yohanselregalado/Yohansel_Regalado_Electiva_2026_C2/Tarea 2/Case PLC.FCStd

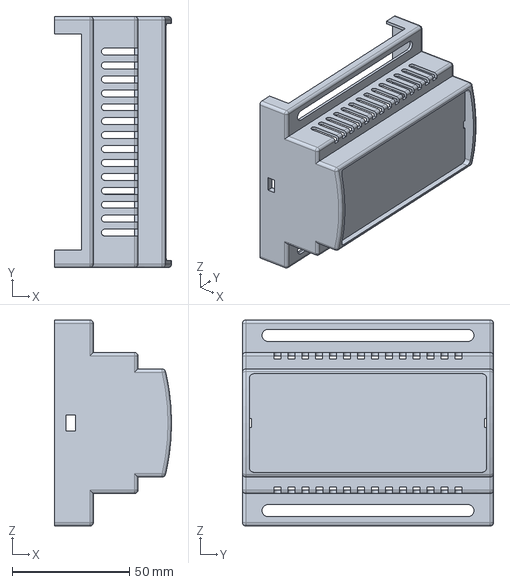
[picture p1: CAD file, 2026-06-11]
Tarea 2/Case PLC.FCStd
49.8 x 107.0 x 87.7 mm
