yohanselregalado/Yohansel_Regalado_Electiva_2026_C2/Tarea 2/Case PLC parte inferior.FCStd

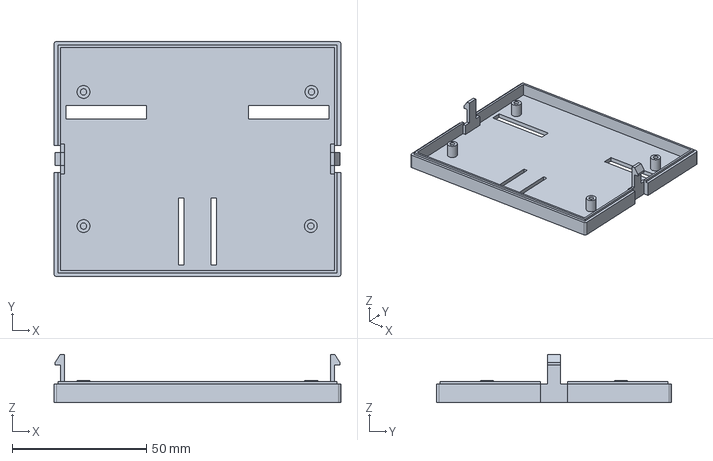
[picture p2: CAD file, 2026-06-11]
Tarea 2/Case PLC parte inferior.FCStd
107.0 x 87.7 x 18.0 mm
