yohanselregalado/Yohansel_Regalado_Electiva_2026_C2/tarea 5/PLC4UNI MEZZANINE.kicad_pcb

## KiCad design tarea 5/PLC4UNI MEZZANINE.kicad_pcb (2026-08-13)

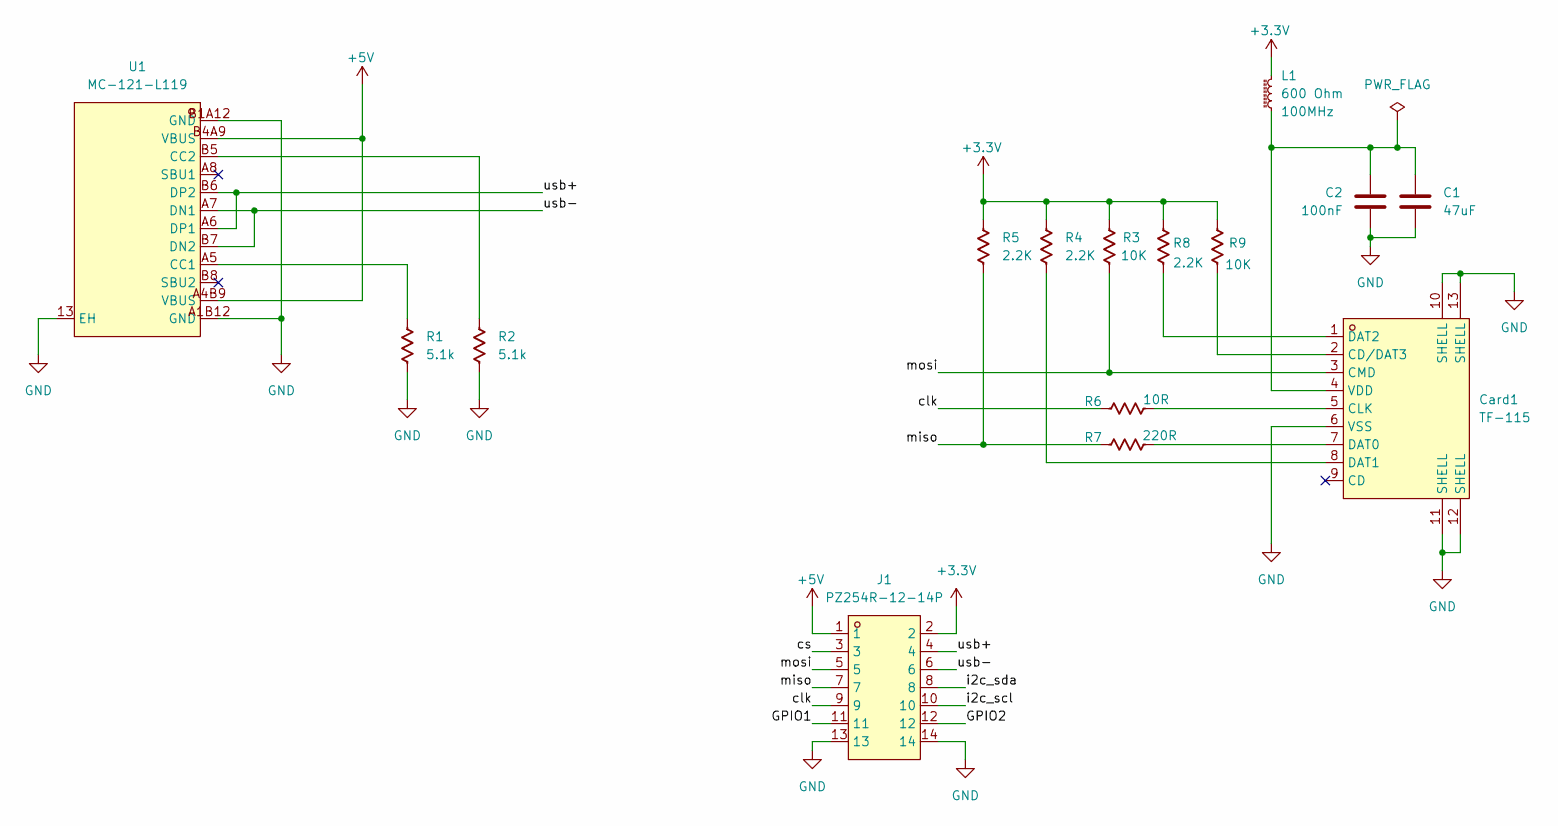
[picture p3: schematic PLC4UNI MEZZANINE.kicad_sch]

Parts:
C1: 47uF; C_0603_1608Metric
C2: 100nF; C_0603_1608Metric
Card1: TF-115; TF-SMD_TF-115; LCSC Part C266620
J1: PZ254R-12-14P; HDR-TH_14P-P2.54-H-M-R2-C7-S2.54; LCSC Part C492435
L1: 600 Ohm; C_0805_2012Metric
R1, R2: 5.1k; R_0603_1608Metric
R3, R9: 10K; R_0603_1608Metric
R4, R5, R8: 2.2K; R_0603_1608Metric
R6: 10R; R_0603_1608Metric
R7: 220R; R_0603_1608Metric
U1: MC-121-L119; USB-C-SMD_HANBO_MC-121-L119; LCSC Part C6332278

Connections:
+3.3V: J1.2, L1.2, R3.1, R4.1, R5.1, R8.1, R9.1
+5V: J1.1, U1.A4B9 (VBUS), U1.B4A9 (VBUS)
/GPIO1: J1.11
/GPIO2: J1.12
/clk: J1.9, R6.1
/cs: J1.3
/i2c_scl: J1.10
/i2c_sda: J1.8
/miso: J1.7, R5.2, R7.1
/mosi: Card1.3 (CMD), J1.5, R3.2
/usb+: J1.4, U1.A6 (DP1), U1.B6 (DP2)
/usb-: J1.6, U1.A7 (DN1), U1.B7 (DN2)
GND: C1.2, C2.2, Card1.6 (VSS), Card1.10 (SHELL), Card1.11 (SHELL), Card1.12 (SHELL), Card1.13 (SHELL), J1.13, J1.14, R1.2, R2.2, U1.13 (EH), U1.A1B12 (GND), U1.B1A12 (GND)
unnamed: Card1.2 (CD/DAT3), R9.2
unnamed: Card1.5 (CLK), R6.2
unnamed: Card1.7 (DAT0), R7.2
unnamed: Card1.8 (DAT1), R4.2
unnamed: Card1.1 (DAT2), R8.2
unnamed: C1.1, C2.1, Card1.4 (VDD), L1.1
unnamed: R1.1, U1.A5 (CC1)
unnamed: R2.1, U1.B5 (CC2)

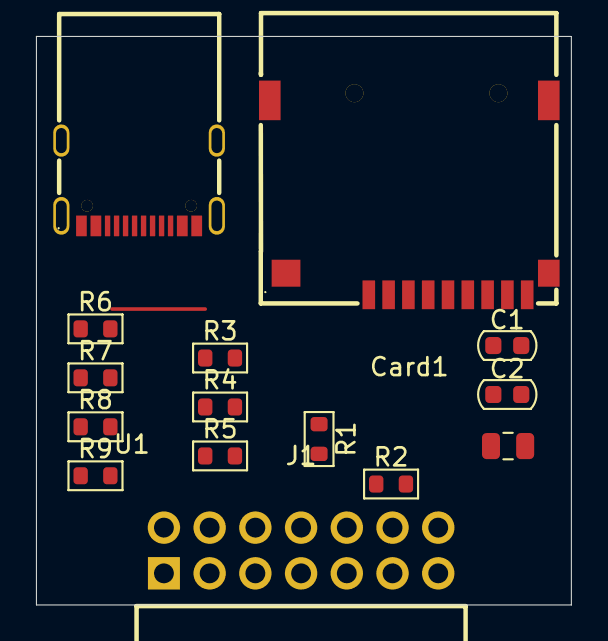
[picture p4: board PLC4UNI MEZZANINE.kicad_pcb from above]

Board: 2 copper layers, 29.7 x 31.6 mm, 15 parts (0 on the bottom side), 16 nets.
