yohanselregalado/Yohansel_Regalado_Electiva_2026_C2/Tarea 3 y 4/tarea 3 y 4/PLC4UNI.kicad_pcb

## KiCad design Tarea 3 y 4/tarea 3 y 4/PLC4UNI.kicad_pcb (2026-07-17)

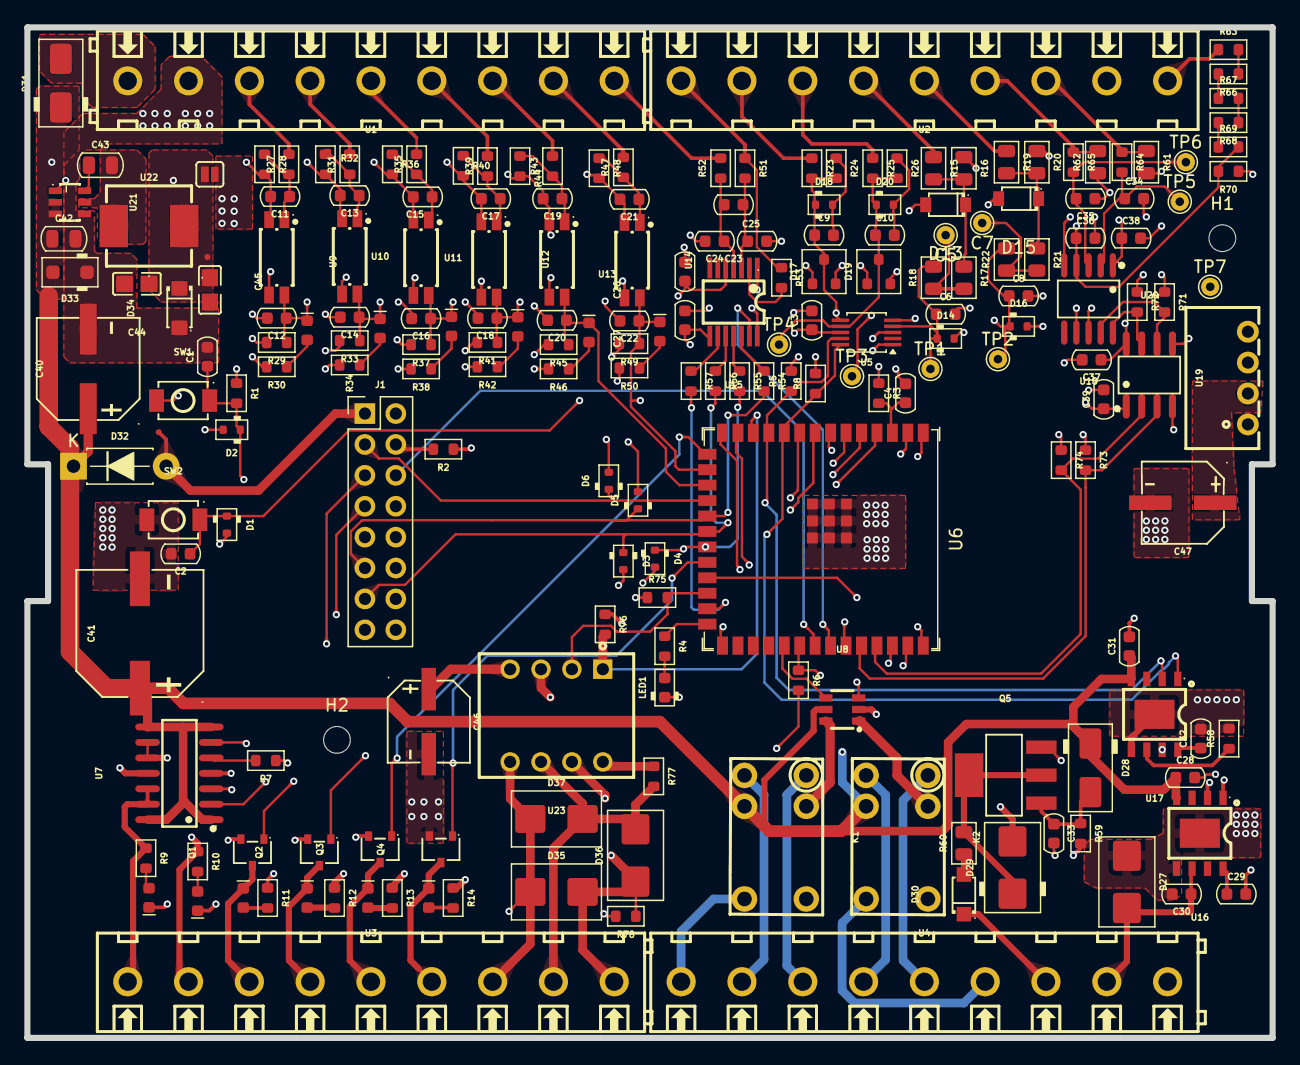
[picture p5: board PLC4UNI.kicad_pcb from above]

Board: 4 copper layers, 102.4 x 83.1 mm, 209 parts (0 on the bottom side), 134 nets.

Parts:
C1, C2, C6, C8: 47pF; C_0603_1608Metric
C3, C9, C10, C23, C24, C25, C26, C27, C30, C37, C38, C39: 100nF; C_0603_1608Metric
C4, C28, C29, C33: 1uF; C_0603_1608Metric
C5, C7: 100nF; TestPoint_THTPad_D1.5mm_Drill0.7mm
C11, C12, C13, C14, C15, C16, C17, C18, C19, C20, C21, C22, C31, C32: C_0603; C_0603_1608Metric
C34, C35: 33nF; C_0603_1608Metric
C36: 68nF; C_0603_1608Metric
C40: 100uF/50V; CAP-SMD_BD8.0-L8.3-W8.3-FD
C41: 220uF/50V; CAP-SMD_BD10.0-L10.3-W10.3-LS11.3-FD
C42: 10uF/50V; C_0805_2012Metric
C43: 100nF; C_0805_2012Metric
C44, C45: 22uF/16V; C0805
C46, C47: 47uF/16V; CAP-SMD_BD6.3-L6.6-W6.6-FD
D1, D2, D3, D4, D5, D6: ESD5Z3.3T; D_SOD-523
D7, D8, D9, D10, D11, D12, D21, D22, D23, D24, D25, D26: Red; LED_0603_1608Metric_Red
D13, D15: 1N5819HW-7-F; SOD-123_L2.7-W1.6-LS3.7-RD
D14, D16, D18, D20: PESD5Z3.3; D_SOD-523
D17, D19: BAT54S; SOT-23
D27, D35, D36, D37: SMBJ12CA; D_SMB_TVS
D28: SMAJ12A; D_SMA
D29: SMBJ28A; D_SMB
D30: DSK120_C22466355; SOD-123FL_L2.7-W1.8-LS3.8-RD
D31: MBRA340T; D_SMA
D32: 1N5819; D_DO-41_SOD81_P7.62mm_Horizontal
D33: SMF24CA; D_SOD-123F
D34: SMF3.3; SOD-123FL_L3.0-W1.9-LS3.7-FD
H1, H2: MountingHole; MountingHole_2.2mm_M2_DIN965
J1: Conn_02x08_Odd_Even; PinHeader_2x08_P2.54mm_Vertical
JP1: Jumper_2_NO
K1, K2: G5V-1-DC3; RELAY-TH_G5V-1
LED1: LED_0603_Red; LED_0603_1608Metric
Q1, Q2, Q3, Q4: ZXMS6004FFQTA; SOT-23F_L2.9-W1.8-P0.95-LS2.4-BR
Q5: NCE60P04R; SOT-223-3_L6.5-W3.4-P2.30-LS7.0-BR
R1: 100k; R_0603_1608Metric
R2, R6, R7, R51, R52: 0R; R_0603_1608Metric
R3, R65, R77, R78: 1k; R_0603_1608Metric
R4: 2.2k; R_0603_1608Metric
R5, R8: 4.7k; R_0603_1608Metric
R9, R10, R11, R12, R13, R14, R58, R71, R72, R73, R74: R_0603; R_0603_1608Metric
R15, R19: 49.9R; R_0805_2012Metric
R16, R20: 120R; R_0805_2012Metric
R17, R18, R21, R22: R_0805; R_0805_2012Metric
R23, R25: 2.2K; R_0603_1608Metric
R24, R26: 1.05K; R_0603_1608Metric
R27, R31, R35, R39, R43, R47: 3.3K; R_0603_1608Metric
R28, R32, R36, R40, R44, R48: 3.6K; R_0603_1608Metric
R29, R33, R37, R41, R45, R49: 22K; R_0603_1608Metric
R30, R34, R38, R42, R46, R50: 220R; R_0603_1608Metric
R53: 20K; R_0603_1608Metric
R54, R55, R56, R57: 150R; R_0603_1608Metric
R59: 470K; R_0603_1608Metric
R60: 15R; R_0805_2012Metric
R61, R62: R51; R_0805_2012Metric
R63, R66, R67, R68, R69: 390k; R_0603_1608Metric
R64: 1K; R_0603_1608Metric
R70: 510; R_0603_1608Metric
R75, R76: 10k; R_0603_1608Metric
SW1, SW2: TS-1088-AR02016; SW-SMD_L3.9-W3.0-P4.45
TP1, TP2, TP3, TP4, TP5, TP6, TP7: TestPoint; TestPoint_THTPad_D1.5mm_Drill0.7mm
TP8, TP9, TP10: 0.5mm; TestPoint-0.5mm
U1, U2, U3, U4: ScrewTerminal1-1x9-P5.0mm; CONN-TH_9P-P5.00_DB127V-5.0-9P-GN-S
U5: ADS1115IDGS; TSSOP-10_3x3mm_P0.5mm
U6: ESP32-S3-WROOM-1; ESP32-S3-WROOM-1U
U7: BTS723GWXUMA1; SOIC-14_L8.7-W3.9-P1.27-LS6.0-BL
U8: LK1802; SOT-23-6_L2.9-W1.6-P0.95-LS2.8-BR
U9, U10, U11, U12, U13, U14: AT3H4B-CUH-S; SSOP-4_L2.7-W4.6-P1.27-LS7.0-TL
U15: MAX31856MUD+; TSSOP-14_L5.0-W4.4-P0.65-LS6.4-BL
U16: GP8211S-TC50-EW; ESOP-8_L4.9-W3.9-P1.27-LS6.0-BL-EP
U17: GP8302-TC50-EW; ESOP-8_L4.9-W3.9-P1.27-LS6.0-BL-EP
U18: BL0942; SSOP-10_L4.9-W3.9-P1.00-LS6.0-BL
U19: B0303S-1WR3_C7465185; PWRM-TH_BXXXXS-1WR3
U20: ISO7021DR; SOIC-8_L4.9-W3.9-P1.27-LS6.0-BL
U21: AP63203WU-7; TSOT-26_L2.9-W1.6-P0.95-LS2.8-BL
U22: APH0630T4R7M; IND-SMD_L7.0-W6.6_APH0630
U23: TD301M485_C5451847; COMM-TH_TD301M485

Connections:
3.3V: C3.1, C26.1, C27.1, C39.1, C46.1, C47.1, D17.2 (K), D19.2 (K), J1.2, JP1.2 (B), R1.1, R2.1, R3.1, R5.2, R8.2, R11.1, R12.1, R13.1, R14.1, R29.2, R30.2, R33.2, R34.2, R37.2, R38.2, R41.2, R42.2, R45.2, R46.2, R49.2, R50.2, R73.1, R74.1, R75.1, R76.1, U5.8 (VDD), U6.2 (3V3), U7.11 (SPU), U15.5 (AVDD), U15.8 (DVDD), U19.2 (+Vin), U20.1 (VCC1), U23.4 (VCC)
3.3V_P: C37.1, C38.1, R71.1, R72.1, TP7.1 (1_1), U18.1 (VDD), U18.8 (SCLK_BPS), U19.4 (+Vout), U20.8 (VCC2)
+5V: D32.2 (A), J1.1, TP8.1 (1_1)
+24V: D31.2 (A), U1.9
/plc4uni_top/CON-IN_CT_N: R62.2, R65.1, U2.4
/plc4uni_top/CON-IN_CT_P: R61.1, R64.1, U2.3
/plc4uni_top/CON_IN_0-10V_1: R23.1, U2.8
/plc4uni_top/CON_IN_0-10V_2: R25.1, U2.7
/plc4uni_top/CON_IN_4-20MA_1: R15.1, U2.6
/plc4uni_top/CON_IN_4-20MA_2: R19.1, U2.5
/plc4uni_top/CON_IN_NPN1: R27.2, U1.7
/plc4uni_top/CON_IN_NPN2: R31.2, U1.6
/plc4uni_top/CON_IN_NPN3: R35.2, U1.5
/plc4uni_top/CON_IN_NPN4: R39.2, U1.4
/plc4uni_top/CON_IN_PNP1: R43.2, U1.3
/plc4uni_top/CON_IN_PNP2: R47.2, U1.2
/plc4uni_top/CON_IN_TC+: R52.2, U1.1
/plc4uni_top/CON_IN_TC-: R51.1, R53.1, U2.9
/plc4uni_top/CON_IN_VAC-P: R63.1, U2.1
/plc4uni_top/CON_OUT_0-10V_1: C30.1, D27.2 (A), U4.8, U16.6 (VOUT)
/plc4uni_top/CON_OUT_4-20MA_1: D30.1, U4.7
/plc4uni_top/CON_OUT_NPN1: D9.1 (K), Q1.3 (D), U3.3
/plc4uni_top/CON_OUT_NPN2: D10.1 (K), Q2.3 (D), U3.4
/plc4uni_top/CON_OUT_NPN3: D11.1 (K), Q3.3 (D), U3.5
/plc4uni_top/CON_OUT_NPN4: D12.1 (K), Q4.3 (D), U3.6
/plc4uni_top/CON_OUT_PNP1: R9.1, U3.1, U7.12 (OUT1), U7.13 (OUT1)
/plc4uni_top/CON_OUT_PNP2: R10.1, U3.2, U7.9 (OUT2), U7.10 (OUT2)
/plc4uni_top/CON_OUT_RLY1-COM: K1.5, U4.1
/plc4uni_top/CON_OUT_RLY1-NC: K1.1, U4.2
/plc4uni_top/CON_OUT_RLY1-NO: K1.10, U4.3
/plc4uni_top/CON_OUT_RLY2-COM: K2.5, U4.6
/plc4uni_top/CON_OUT_RLY2-NC: K2.1, U4.4
/plc4uni_top/CON_OUT_RLY2-NO: K2.10, U4.5
/plc4uni_top/CON_RS485_A: D35.2 (A), D36.1 (K), R78.1, U3.9, U23.7 (B)
/plc4uni_top/CON_RS485_B: D36.2 (A), D37.2 (A), R77.2, U3.8, U23.6 (A)
/plc4uni_top/CON_RS485_G: D35.1 (K), D37.1 (K), R78.2, U3.7, U23.5 (RGND)
/plc4uni_top/EMRX: R73.2, U6.36 (U0RXD/GPIO44/CLK_OUT2), U20.3 (INB)
/plc4uni_top/EM_TX: R74.2, U6.37 (U0TXD/GPIO43/CLK_OUT1), U20.2 (OUTA)
/plc4uni_top/EN: C4.1, R3.2, U6.3 (EN)
/plc4uni_top/I2C_SCK: J1.10, R8.1, U5.10 (SCL), U6.10 (GPIO17/U1TXD/ADC2_CH6), U16.1 (SCLK), U17.1 (SLCK)
/plc4uni_top/I2C_SDA: J1.8, R5.1, U5.9 (SDA), U6.11 (GPIO18/U1RXD/ADC2_CH7/CLK_OUT3), U16.2 (SDA), U17.2 (SDA)
/plc4uni_top/IN-0-10V1/COM: C10.2, D20.2 (A), R26.1
/plc4uni_top/IN-0-10V1/OUT3V3: C10.1, D19.3 (C), D20.1 (K), R25.2, R26.2, TP4.1 (1_1), U5.7 (AIN3)
/plc4uni_top/IN-0-10V/COM: C9.2, D18.2 (A), R24.1
/plc4uni_top/IN-0-10V/OUT3V3: C9.1, D17.3 (C), D18.1 (K), R23.2, R24.2, TP3.1 (1_1), U5.6 (AIN2)
/plc4uni_top/IN-4-20MA1/OUT: C8.1, D16.1 (K), R22.2, TP2.1 (1_1), U5.5 (AIN1)
/plc4uni_top/IN-4-20MA/OUT: C6.1, D14.1 (K), R18.2, TP1.1 (1_1), U5.4 (AIN0)
/plc4uni_top/IN_NPN1: C12.1, D21.1 (K), R29.1, U6.4 (GPIO4/TOUCH4/ADC1_CH3), U9.4 (COL)
/plc4uni_top/IN_NPN2: C14.1, D22.1 (K), R33.1, U6.5 (GPIO5/TOUCH5/ADC1_CH4), U10.4 (COL)
/plc4uni_top/IN_NPN3: C16.1, D23.1 (K), R37.1, U6.6 (GPIO6/TOUCH6/ADC1_CH5), U11.4 (COL)
/plc4uni_top/IN_NPN4: C18.1, D24.1 (K), R41.1, U6.7 (GPIO7/TOUCH7/ADC1_CH6), U12.4 (COL)
/plc4uni_top/IN_PNP1: C20.1, D25.1 (K), R45.1, U6.17 (GPIO9/TOUCH9/ADC1_CH8/FSPIHD/SUBSPIHD), U13.4 (COL)
/plc4uni_top/IN_PNP2: C2.1, C22.1, D1.1 (K), D26.1 (K), R49.1, SW2.2, U6.16 (GPIO46), U14.4 (COL)
/plc4uni_top/LCD_CS: J1.7, U6.35 (MTMS/GPIO42)
/plc4uni_top/LCD_EN: J1.4, R2.2
/plc4uni_top/LED_INFO: R4.1, U6.26 (GPIO45)
/plc4uni_top/OUT-PNP/ST1: R6.2, U7.3 (ST1)
/plc4uni_top/OUT-PNP/ST2: R7.2, U7.5 (ST2)
/plc4uni_top/OUT_NPN1: Q1.1 (IN), U6.39 (GPIO1/TOUCH1/ADC1_CH0)
/plc4uni_top/OUT_NPN2: Q2.1 (IN), U6.38 (GPIO2/TOUCH2/ADC1_CH1)
/plc4uni_top/OUT_NPN3: Q3.1 (IN), U6.15 (GPIO3/TOUCH3/ADC1_CH2)
/plc4uni_top/OUT_NPN4: Q4.1 (IN), U6.22 (GPIO14/TOUCH14/ADC2_CH3/FSPIWP/FSPIDQS/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)
/plc4uni_top/OUT_PNP1: U6.8 (GPIO15/U0RTS/ADC2_CH4/XTAL_32K_P), U7.2 (IN1)
/plc4uni_top/OUT_PNP2: U6.9 (GPIO16/U0CTS/ADC2_CH5/XTAL_32K_N), U7.6 (IN2)
/plc4uni_top/OUT_RLY1: U6.23 (GPIO21), U8.3 (1B)
/plc4uni_top/OUT_RLY2: U6.31 (GPIO38/FSPIWP/SUBSPIWP), U8.4 (2B)
/plc4uni_top/RESET: C1.1, D2.1 (K), J1.5, R1.2, SW1.2, U6.27 (GPIO0/BOOT)
/plc4uni_top/RS485-RX: R76.2, U6.12 (GPIO8/TOUCH8/ADC1_CH7/SUBSPICS1), U23.1 (RXD)
/plc4uni_top/RS485-TX: R75.2, U6.24 (GPIO47/SPICLK_P/SUBSPICLK_P_DIFF), U23.2 (TXD)
/plc4uni_top/SD_CS: D6.1 (K), J1.3, U6.18 (GPIO10/TOUCH10/ADC1_CH9/FSPICS0/FSPIIO4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)
/plc4uni_top/SPI_CLK: D3.1 (K), J1.13, R56.2, U6.20 (GPIO12/TOUCH12/ADC2_CH1/FSPICLK/FSPIIO6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)
/plc4uni_top/SPI_MISO: D4.1 (K), J1.9, R55.2, U6.21 (GPIO13/TOUCH13/ADC2_CH2/FSPIQ/FSPIIO7/S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)
/plc4uni_top/SPI_MOSI: D5.1 (K), J1.11, R54.2, U6.19 (GPIO11/TOUCH11/ADC2_CH0/FSPID/FSPIIO5/S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)
/plc4uni_top/ST1_ST2: R6.1, R7.1, U6.32 (MTCK/GPIO39/CLK_OUT3/SUBSPICS1)
/plc4uni_top/TC_FAULT: U6.34 (MTDI/GPIO41/CLK_OUT1), U15.13 (~FAULT)
/plc4uni_top/TEMP_CS: R57.2, U6.25 (GPIO48/SPICLK_N/SUBSPICLK_N_DIFF)
/plc4uni_top/TP_INT: J1.6, U6.33 (MTDO/GPIO40/CLK_OUT2)
/plc4uni_top/USB+: J1.14, U6.14 (GPIO20/U1CTS/ADC2_CH9/CLK_OUT1/USB_D+)
/plc4uni_top/USB-: J1.12, U6.13 (GPIO19/U1RTS/ADC2_CH8/CLK_OUT2/USB_D-)
Earth: C34.2, C35.1, C36.2, C37.2, C38.2, R61.2, R62.1, R70.1, U2.2, U18.5 (GND), U18.7 (SEL), U19.3 (-Vout), U20.5 (GND2)
GND: C1.2, C2.2, C3.2, C4.2, C6.2, C8.2, C12.2, C14.2, C16.2, C18.2, C19.2, C20.2, C21.2, C22.2, C24.2, C25.2, C26.2, C27.2, C28.2, C29.2, C30.2, C31.2, C32.2, C33.2, C39.2, C40.2, C41.2, C42.2, C44.2, C45.2, C46.2, C47.2, D1.2 (A), D2.2 (A), D3.2 (A), D4.2 (A), D5.2 (A), D6.2 (A), D7.1 (K), D8.1 (K), D13.2, D14.2 (A), D15.2, D16.2 (A), D17.1 (A), D19.1 (A), D27.1 (K), D29.2 (A), D33.1 (K), D34.1, J1.15, J1.16, LED1.1 (K), Q1.2 (S), Q2.2 (S), Q3.2 (S), Q4.2 (S), R16.1, R20.1, R44.2, R48.2, R58.2, R59.2, SW1.1, SW2.1, U1.8, U4.9, U5.1 (ADDR), U5.3 (GND), U6.1 (GND), U6.40 (GND), U6.41 (GND), U7.4 (GND), U8.2 (E), U9.3 (EM), U10.3 (EM), U11.3 (EM), U12.3 (EM), U13.2 (CAT/AN), U13.3 (EM), U14.2 (CAT/AN), U14.3 (EM), U15.1 (AGND), U15.14 (DGND), U16.5 (GND), U16.9 (EP), U17.5 (GND), U17.9 (EP), U19.1 (-Vin), U20.4 (GND1), U21.4 (GND), U23.3 (GND)
unnamed: C5.1, R17.2, R18.1
unnamed: C7.1, R21.2, R22.1
unnamed: D7.2 (A), R9.2
unnamed: D8.2 (A), R10.2
unnamed: D9.2 (A), R11.2
unnamed: D10.2 (A), R12.2
unnamed: D11.2 (A), R13.2
unnamed: D12.2 (A), R14.2
unnamed: D13.1, R15.2, R16.2, R17.1
unnamed: D15.1, R19.2, R20.2, R21.1
unnamed: D21.2 (A), R30.1
unnamed: D22.2 (A), R34.1
unnamed: D23.2 (A), R38.1
unnamed: D24.2 (A), R42.1
unnamed: D25.2 (A), R46.1
unnamed: D26.2 (A), R50.1
unnamed: C33.1, D28.2 (A), Q5.1 (G), R59.1
unnamed: D29.1 (K), Q5.2 (D), Q5.4 (D), R60.2
unnamed: D30.2, R60.1
unnamed: C44.1, C45.1, D34.2, JP1.1 (A), TP10.1 (1_1), U21.1 (FB), U22.2
unnamed: LED1.2 (A), R4.2
unnamed: Q5.3 (S), U17.7 (IOUT)
unnamed: R63.2, R66.1
unnamed: R66.2, R67.1
unnamed: R67.2, R68.1
unnamed: R68.2, R69.1
unnamed: K2.9, U8.1 (1C)
unnamed: K1.9, U8.6 (2C)
unnamed: C11.1, R27.1, R28.1, U9.1 (AN/CAT)
unnamed: C13.1, R31.1, R32.1, U10.1 (AN/CAT)
unnamed: C15.1, R35.1, R36.1, U11.1 (AN/CAT)
unnamed: C17.1, R39.1, R40.1, U12.1 (AN/CAT)
unnamed: C19.1, R43.1, R44.1, U13.1 (AN/CAT)
unnamed: C21.1, R47.1, R48.1, U14.1 (AN/CAT)
unnamed: R53.2, U15.2 (BIAS)
unnamed: R56.1, U15.10 (SCK)
unnamed: R54.1, U15.12 (SDI)
unnamed: R55.1, U15.11 (SDO)
unnamed: C23.2, C24.1, R52.1, U15.4 (T+)
unnamed: C23.1, C25.1, R51.2, U15.3 (T-)
unnamed: R57.1, U15.9 (~CS)
unnamed: C29.1, U16.8 (V5V)
unnamed: R58.1, U17.6 (SET)
unnamed: C32.1, U17.8 (V5V)
unnamed: C35.2, R65.2, TP6.1 (1_1), U18.3 (IN)
unnamed: C34.1, R64.2, TP5.1 (1_1), U18.2 (IP)
unnamed: R71.2, U18.9 (RX/SDI), U20.6 (OUTB)
unnamed: R72.2, U18.10 (TX/SDO), U20.7 (INA)
unnamed: C36.1, R69.2, R70.2, U18.4 (VP)
unnamed: C43.1, U21.6 (BST)
unnamed: C43.2, U21.5 (SW), U22.1
unnamed: R77.1, U23.8 (VO)
VCC: C11.2, C13.2, C15.2, C17.2, C28.1, C31.1, C40.1, C41.1, C42.1, D28.1 (K), D31.1 (K), D32.1 (K), D33.2 (A), K1.2, K2.2, R28.2, R32.2, R36.2, R40.2, TP9.1 (1_1), U7.1 (VBB), U7.7 (VBB), U7.8 (VBB), U7.14 (VBB), U8.5 (COM), U9.2 (CAT/AN), U10.2 (CAT/AN), U11.2 (CAT/AN), U12.2 (CAT/AN), U16.4 (VCC), U17.4 (VCC), U21.2 (EN), U21.3 (VIN)
