yohanselregalado/Yohansel_Regalado_Electiva_2026_C2/(commit log)

2026-06-11 Tarea 2
    [Case PLC parte inferior.FCStd, Case PLC.FCStd]
2026-07-16 tarea 3 y 4
    [ENERGY METER_sch.kicad_sch, IN-0-10V_sch.kicad_sch, IN-DI1_sch.kicad_sch, OUT-NPN_sch.kicad_sch, OUT-PNP_sch.kicad_sch, POWERSUPPLY_sch.kicad_sch, RLY_sch.kicad_sch, TC_sch.kicad_sch]
